efeanilarslan/Two-Stage-BJT-Audio-Amplifier/docs/oscilloscope_report.pdf

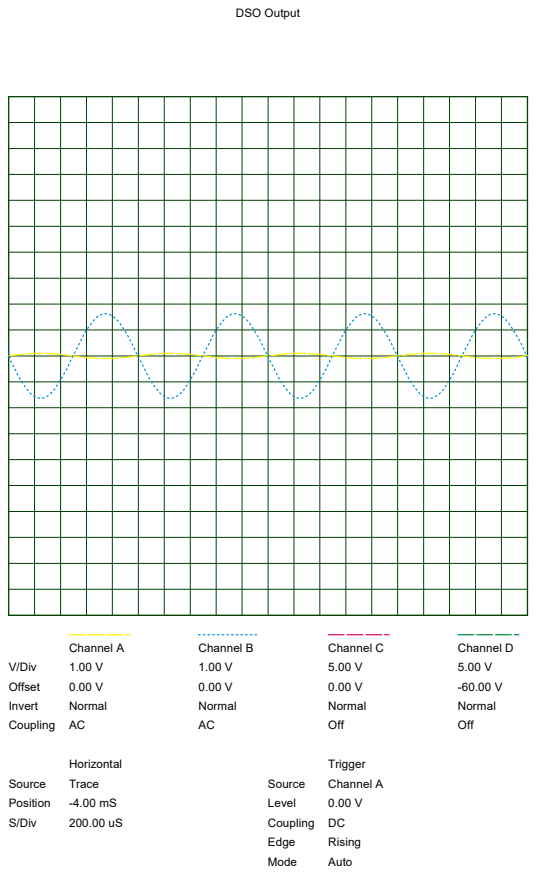
[picture p5: page 1]
DSO Output; V/Div Offset Invert Coupling; Channel A 1.00 V 0.00 V Normal AC; Channel B 1.00 V 0.00 V Normal AC; Channel C 5.00 V 0.00 V Normal Off; Channel D 5.00 V -60.00 V Normal Off; Horizontal; Source Position S/Div; Trace -4.00 mS 200.00 uS; Trigger; Source Level Coupling Edge Mode; Channel A 0.00 V DC Rising Auto
