efeanilarslan/Two-Stage-BJT-Audio-Amplifier/docs/pcb_mask_panelized.pdf

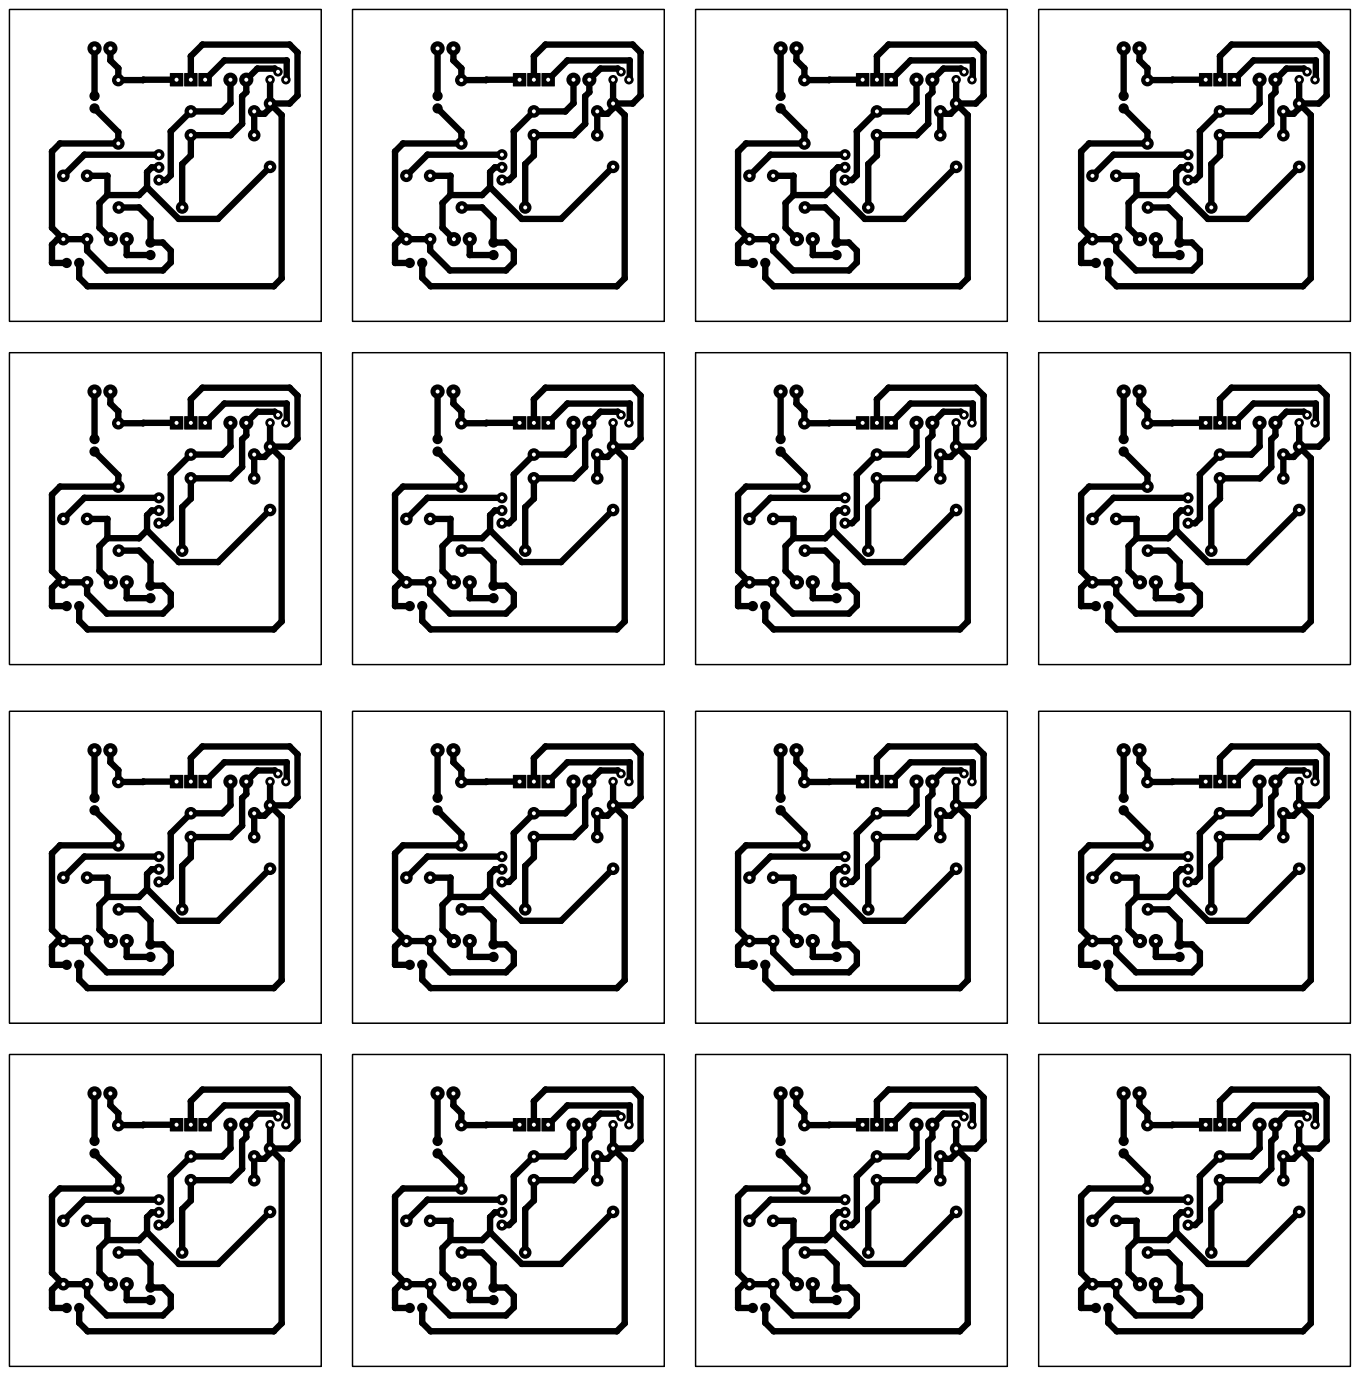
[picture p6: page 1]
