efeanilarslan/Two-Stage-BJT-Audio-Amplifier/(list of files, drawings)

Other design files:
amfi(ilkkat).pdsprj
amfi(SON).pdsprj
amfi.pdsprj
